JacobG111/TractionInverter/README.md

# TractionInverter

# https://www.youtube.com/watch?v=JSVvojoRwVg
