JacobG111/TractionInverter/TractionInverterLib/TractionInverter.3d/AP7387-50W5-7.stp

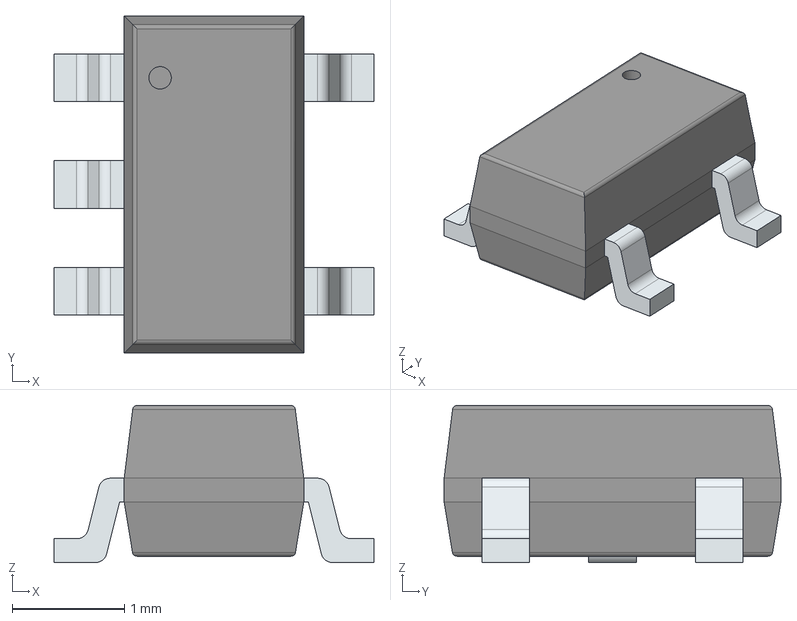
[picture p1: CAD file, 2025-09-23]
TractionInverterLib/TractionInverter.3d/AP7387-50W5-7.stp
2.85 x 3.00 x 1.40 mm
PinsArrayL
PinsArrayR
