JacobG111/TractionInverter/TractionInverterLib/TractionInverter.3d/5281.step

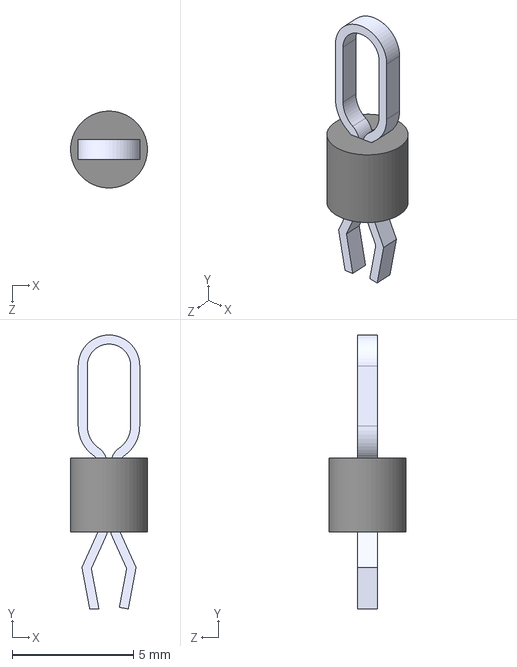
[picture p2: CAD file, 2025-09-23]
TractionInverterLib/TractionInverter.3d/5281.step
3.17 x 11.3 x 3.17 mm
