JacobG111/TractionInverter/TractionInverterLib/TractionInverter.3d/EKXJ251ELL331MM40S.stp

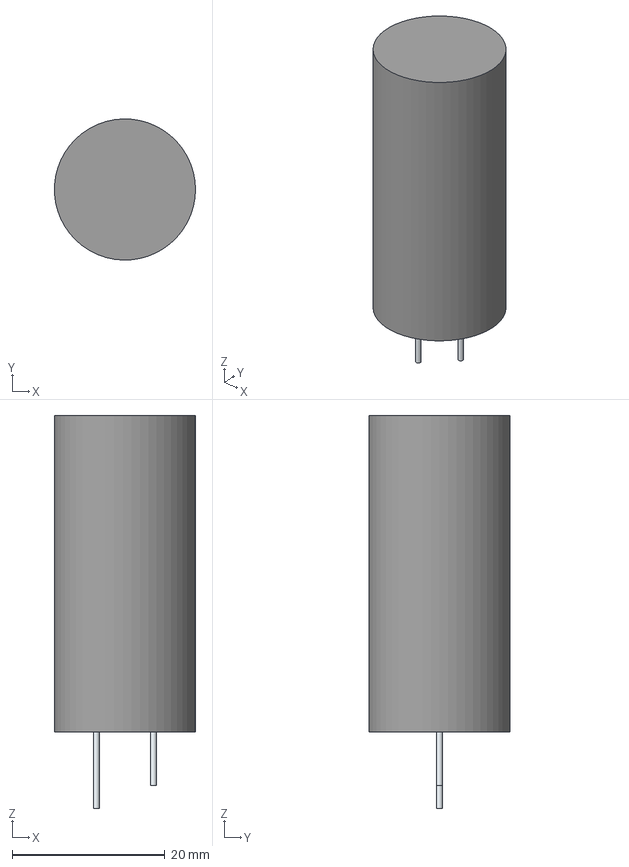
[picture p3: CAD file, 2025-09-23]
TractionInverterLib/TractionInverter.3d/EKXJ251ELL331MM40S.stp
18.5 x 18.5 x 51.5 mm
SimpleBody
Pin1
Pin2
