JacobG111/TractionInverter/TractionInverterLib/TractionInverter.3d/7447745100.stp

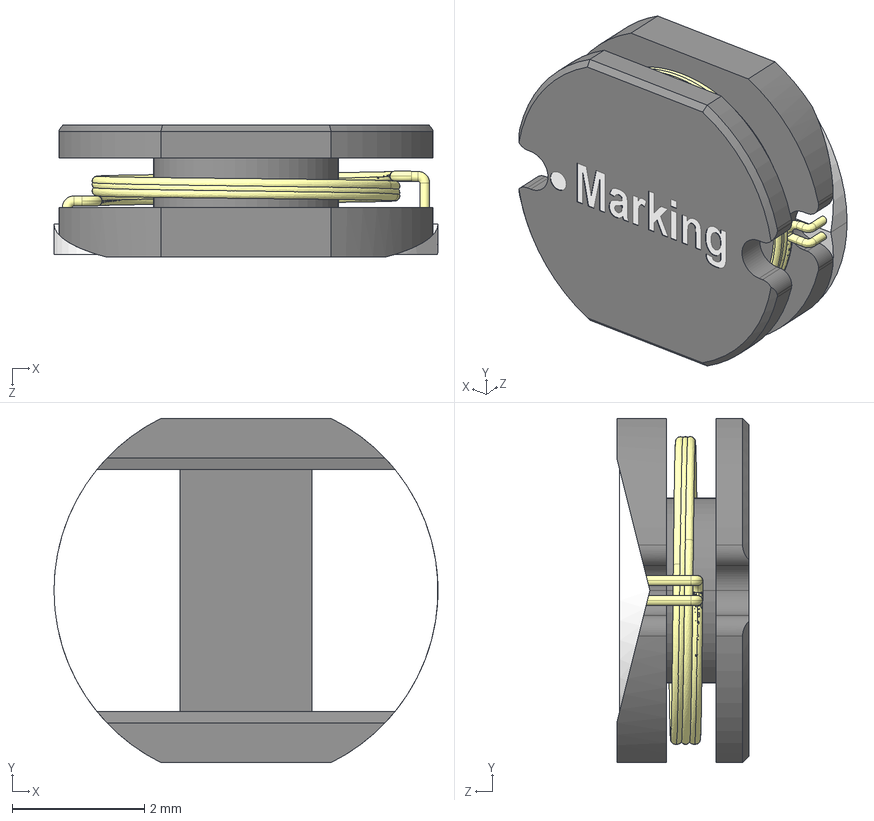
[picture p4: CAD file, 2025-09-23]
TractionInverterLib/TractionInverter.3d/7447745100.stp
5.80 x 5.20 x 2.00 mm
