JacobG111/TractionInverter/TractionInverterLib/TractionInverter.3d/744045004.stp

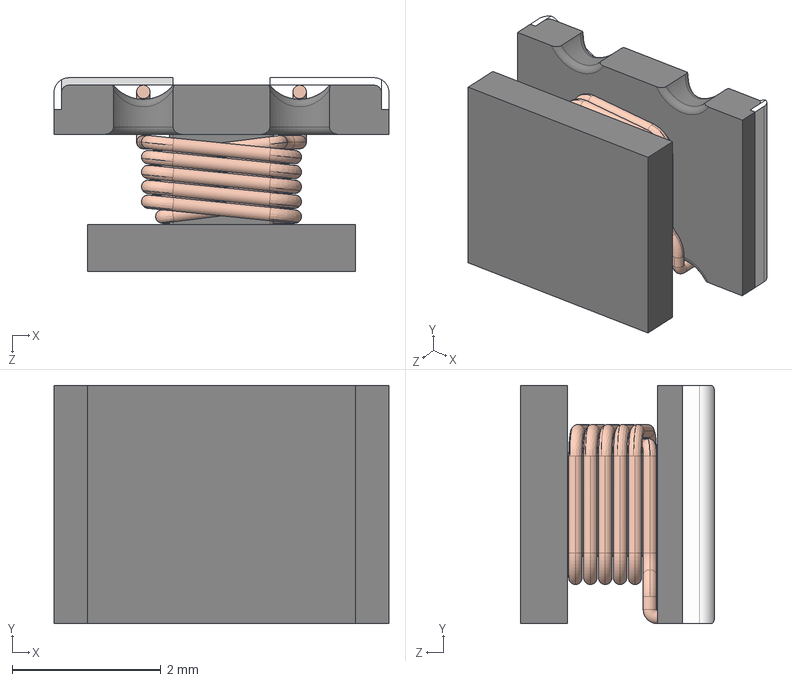
[picture p5: CAD file, 2025-09-23]
TractionInverterLib/TractionInverter.3d/744045004.stp
4.50 x 3.20 x 2.60 mm
